moschotto/OpenTX_EdgeTX_Bluetooth_GamePad/Media/antenna_led.jpg

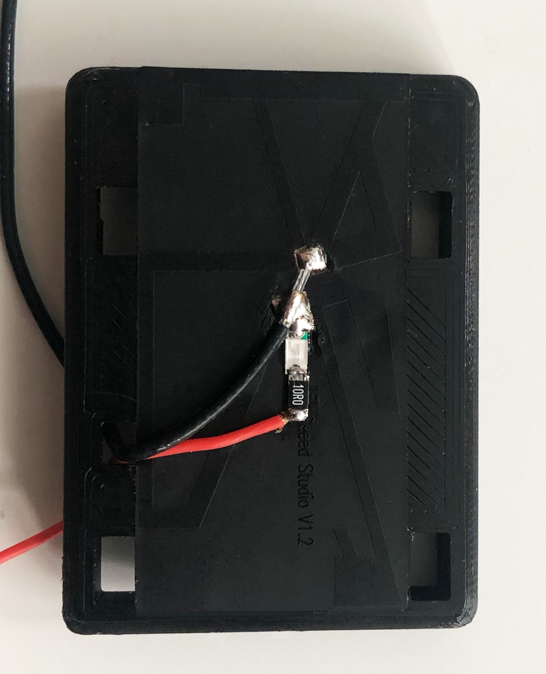
Media/antenna_led.jpg
