moschotto/OpenTX_EdgeTX_Bluetooth_GamePad/Media/back.png

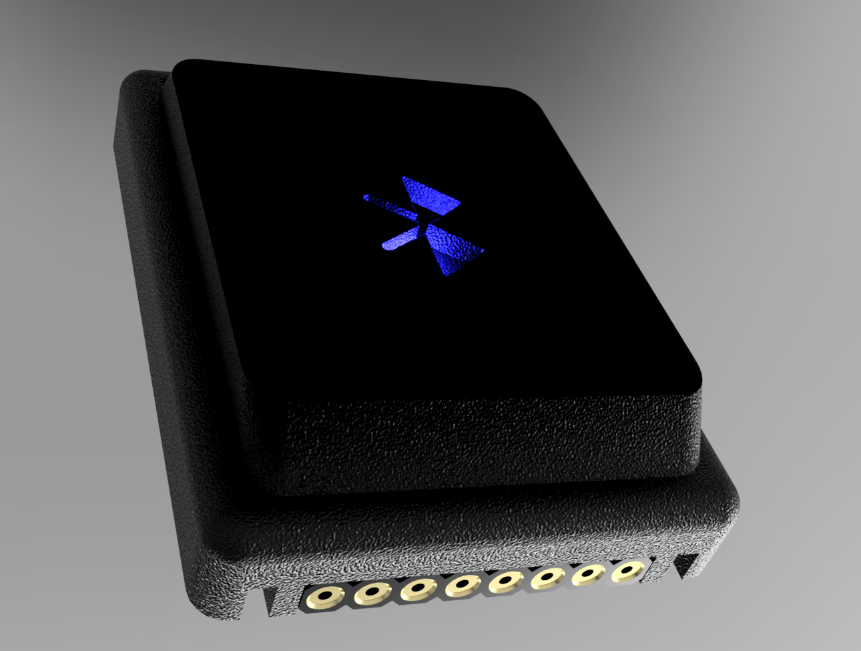
Media/back.png
