moschotto/OpenTX_EdgeTX_Bluetooth_GamePad/Media/IMG_0432.jpg

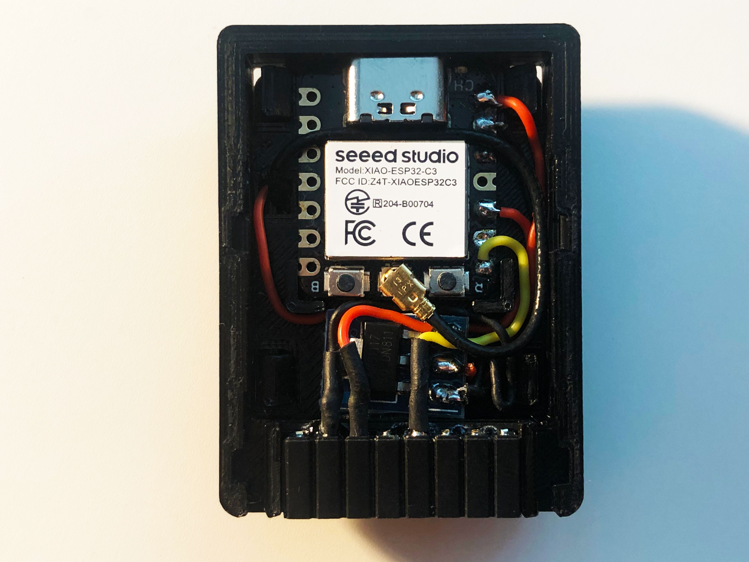
Media/IMG_0432.jpg
