moschotto/OpenTX_EdgeTX_Bluetooth_GamePad/Media/IMG_0434.jpg

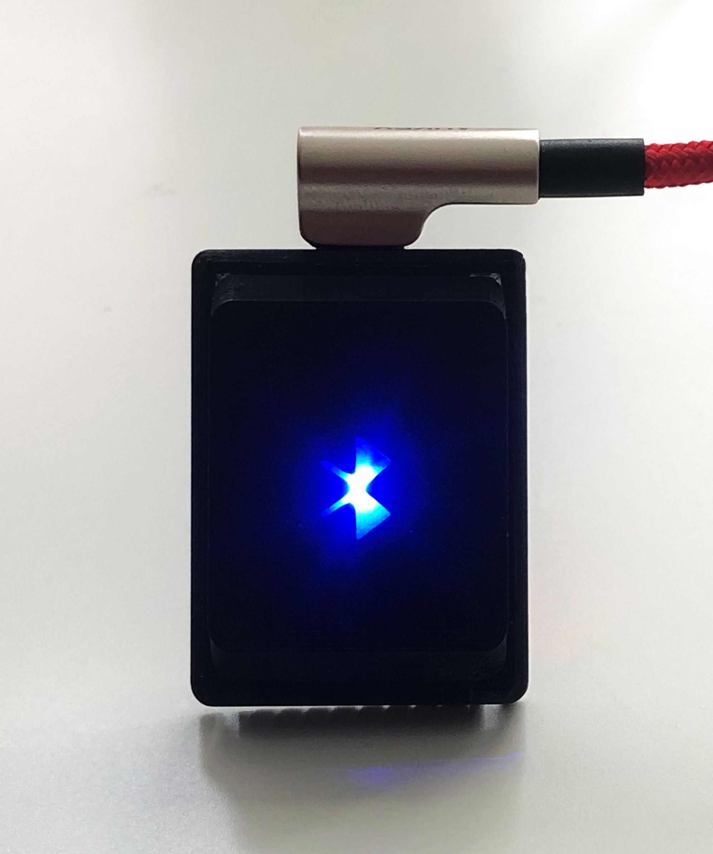
Media/IMG_0434.jpg
