moschotto/OpenTX_EdgeTX_Bluetooth_GamePad/Media/IMG_0435.jpg

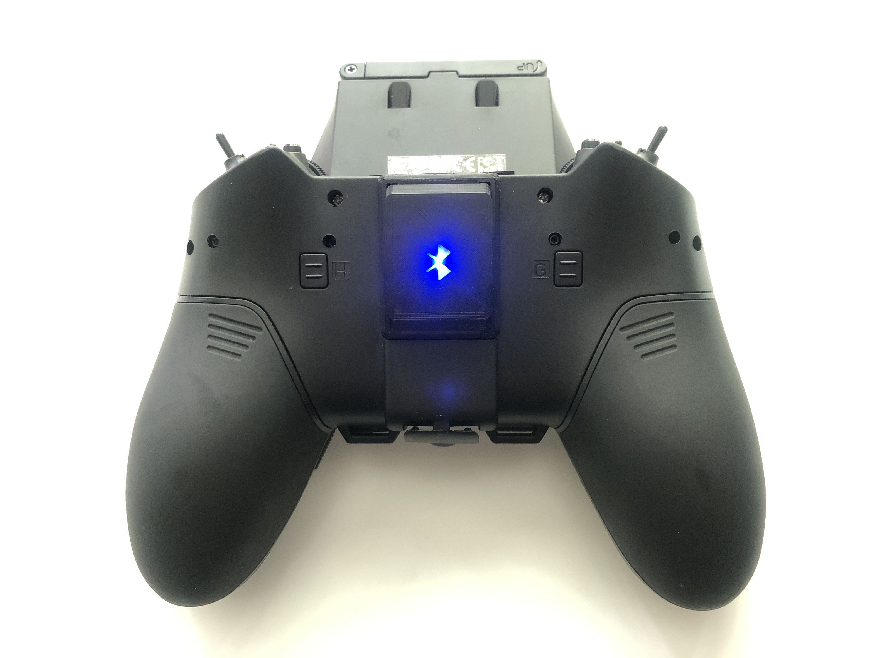
Media/IMG_0435.jpg
