moschotto/OpenTX_EdgeTX_Bluetooth_GamePad/Media/IMG_0436.jpg

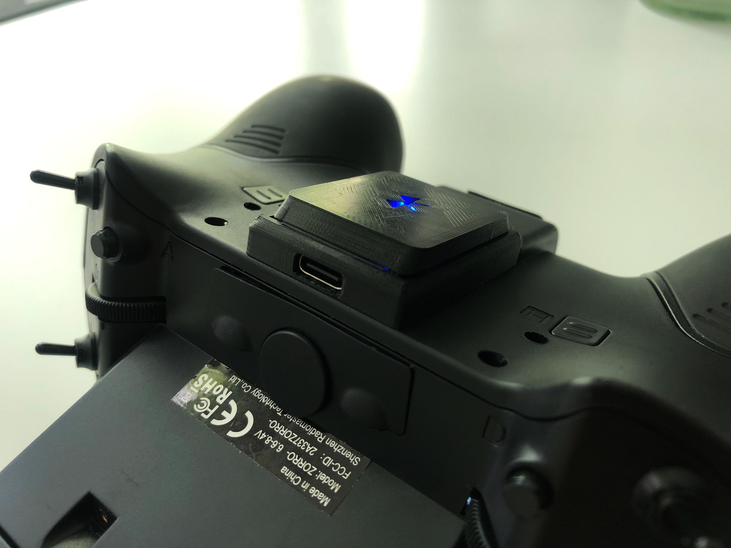
Media/IMG_0436.jpg
