moschotto/OpenTX_EdgeTX_Bluetooth_GamePad/Media/IMG_0453.jpg

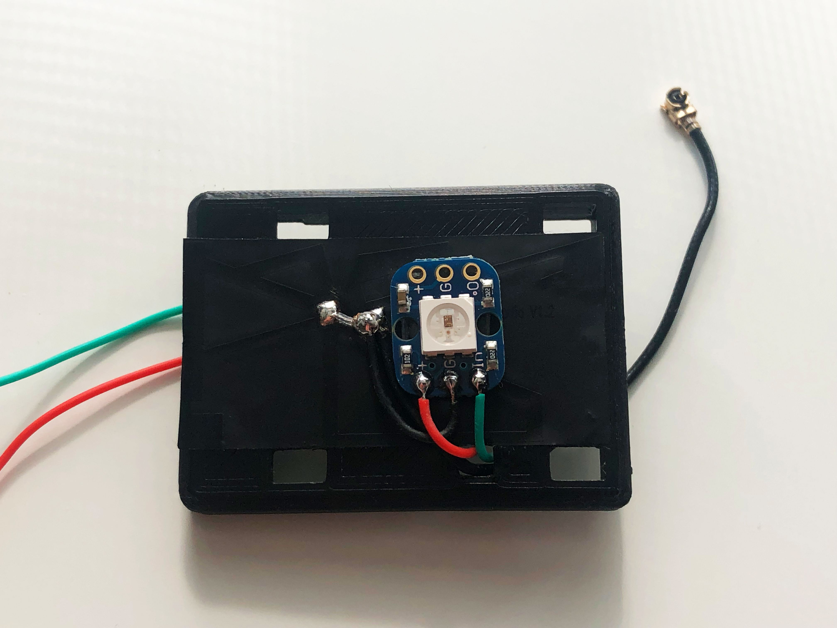
Media/IMG_0453.jpg
