moschotto/OpenTX_EdgeTX_Bluetooth_GamePad/(threads)

Thread 1 (2023-03-28):

problem with compile

lukaszwitkowski, 2023-03-28:
can you help me with your software?
i have errors in arduino
Can you make for me bin file?

Eisbaeeer, 2025-06-01:
I will do a pull-request with working code. You will find the fork here: [https://github.com/Eisbaeeer/OpenTX_EdgeTX_Bluetooth_GamePad](https://github.com/Eisbaeeer/OpenTX_EdgeTX_Bluetooth_GamePad)
